rhitvik/Stationery_Vending_Machine/Images_and_Screenshots/Completed_PCB.jpg

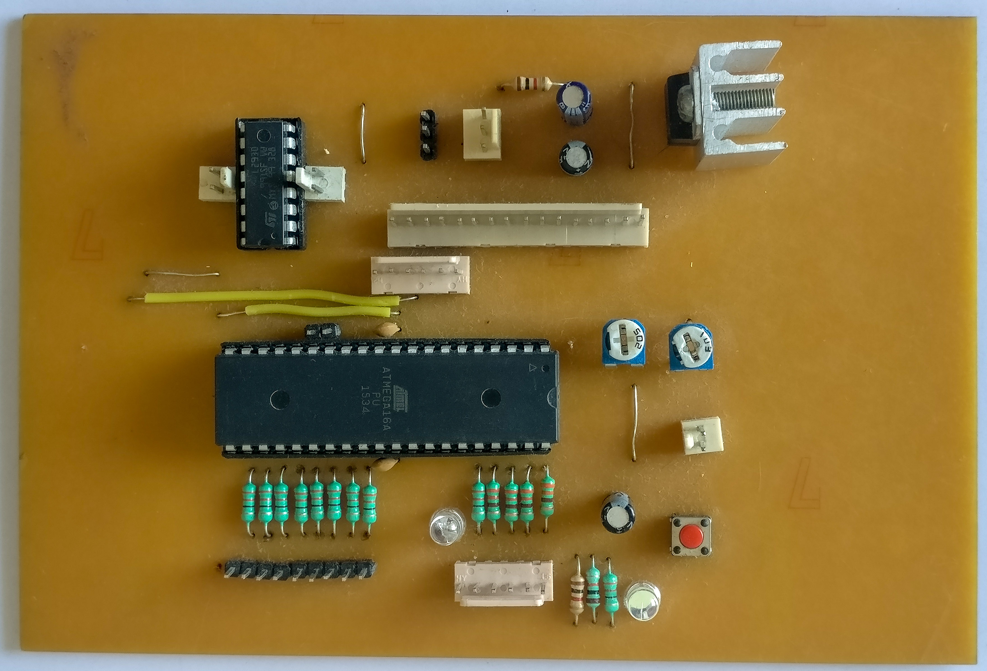
Images_and_Screenshots/Completed_PCB.jpg
