rhitvik/Stationery_Vending_Machine/Images_and_Screenshots/PCB_Visualization_back.JPG

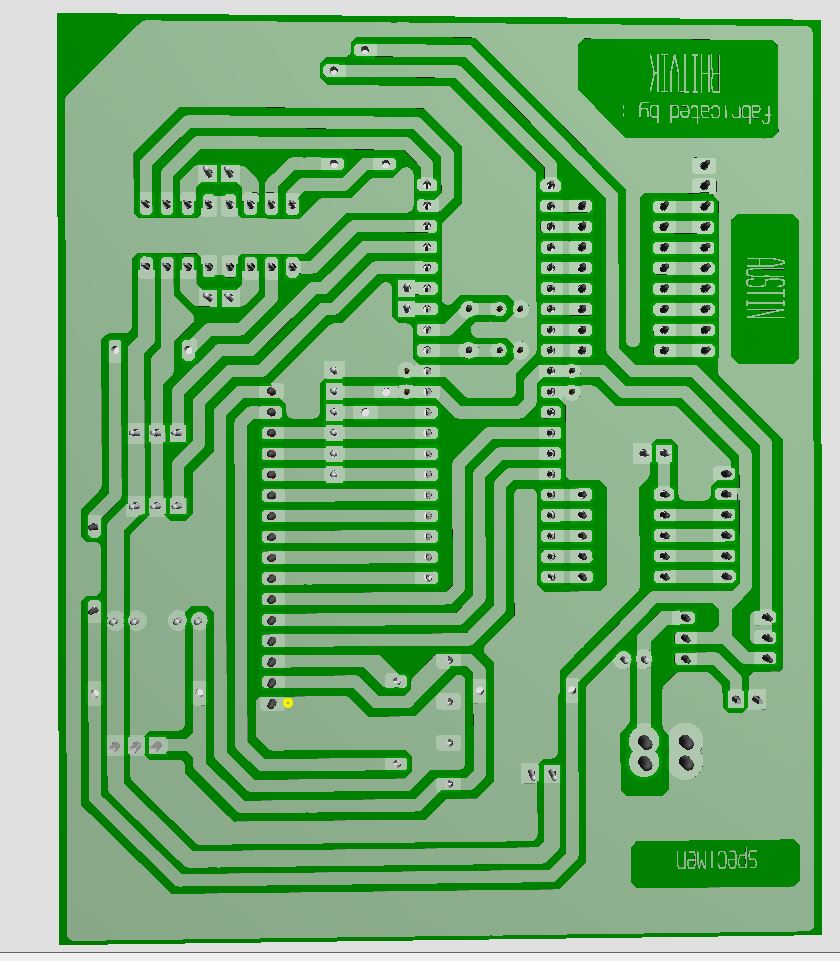
Images_and_Screenshots/PCB_Visualization_back.JPG
