rhitvik/Stationery_Vending_Machine/Images_and_Screenshots/Vending_Machine_JECRC_University.jpg

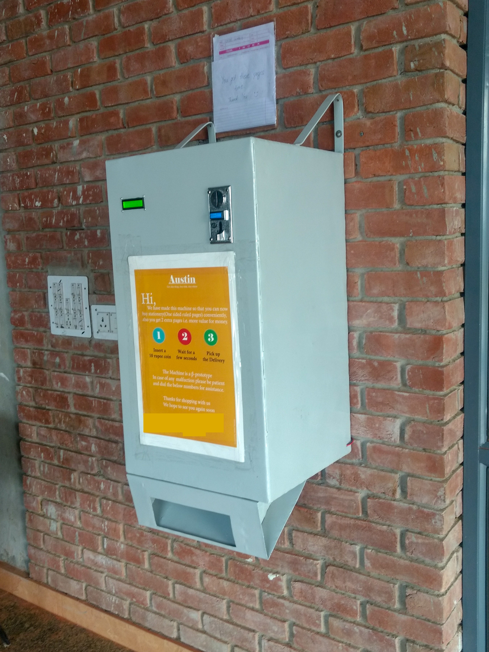
Images_and_Screenshots/Vending_Machine_JECRC_University.jpg
