rhitvik/Stationery_Vending_Machine/Images_and_Screenshots/Vending_Machine_SKIT_Jaipur.jpg

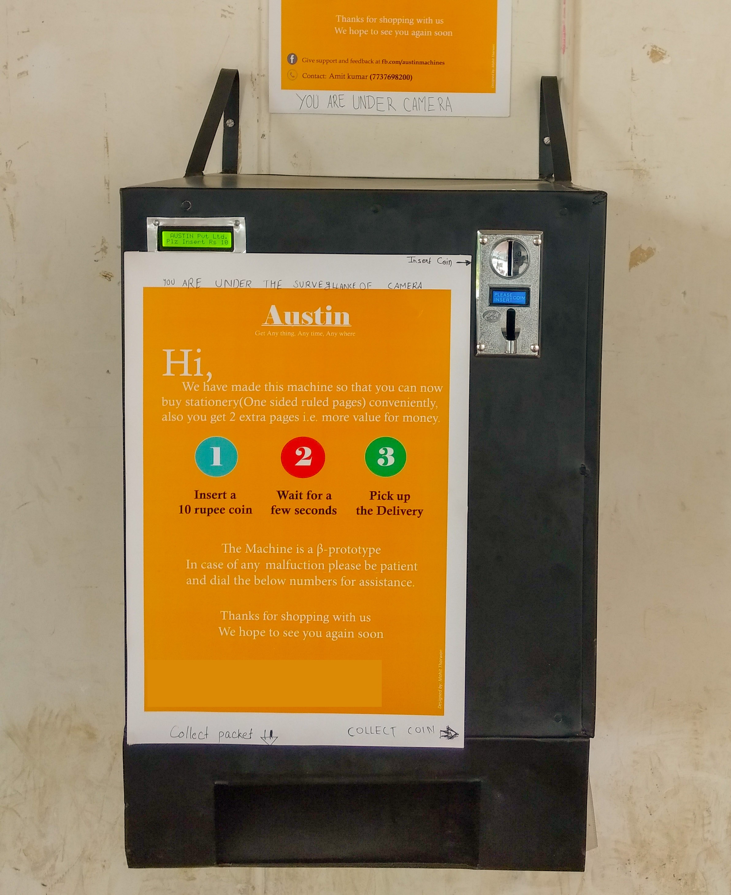
Images_and_Screenshots/Vending_Machine_SKIT_Jaipur.jpg
