rhitvik/Stationery_Vending_Machine/Images_and_Screenshots/PCB_Visualization_no_components_front.JPG

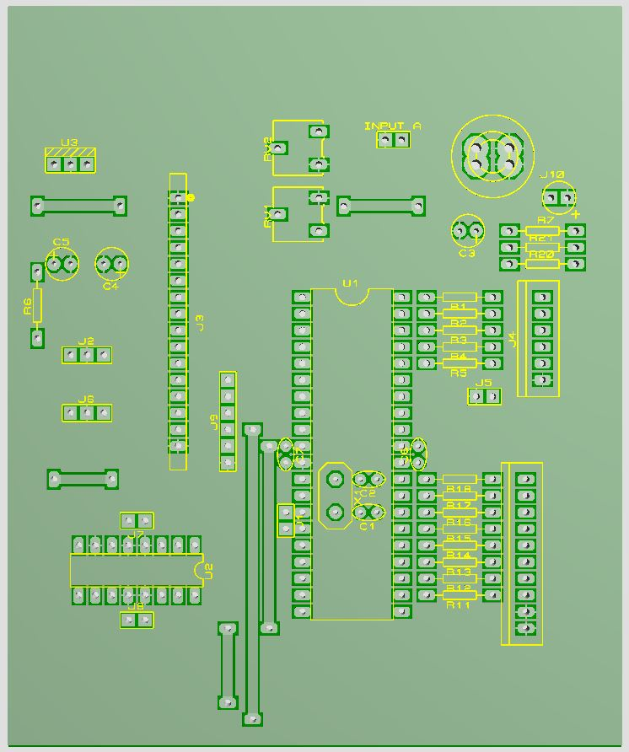
Images_and_Screenshots/PCB_Visualization_no_components_front.JPG
