rhitvik/Stationery_Vending_Machine/Images_and_Screenshots/PCB_Visualization_with_components_front.JPG

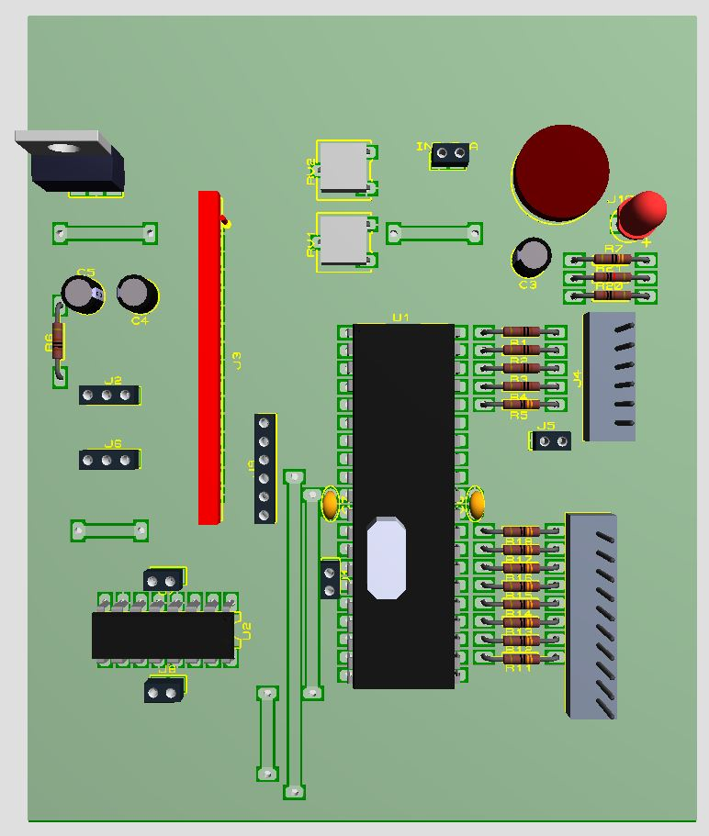
Images_and_Screenshots/PCB_Visualization_with_components_front.JPG
