rhitvik/Stationery_Vending_Machine/(list of files, drawings)

Other design files:
Schematic&PCB_layout/vending machine single product circuit.DSN
Schematic&PCB_layout/vending machine single product circuit.LYT
SimluationFile/vending machine single product.DSN
