rhitvik/Stationery_Vending_Machine/Images_and_Screenshots/Fabricated_PCB.jpg

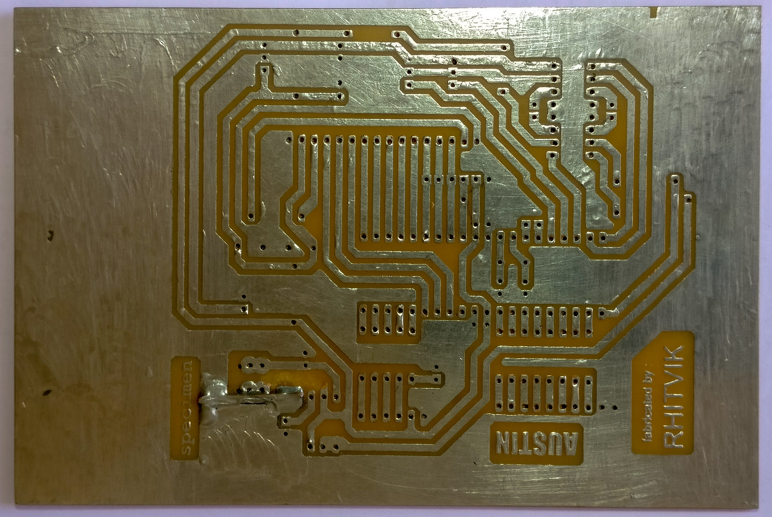
Images_and_Screenshots/Fabricated_PCB.jpg
